OddbitCoder/PartnerGDP/fix/fix1.png

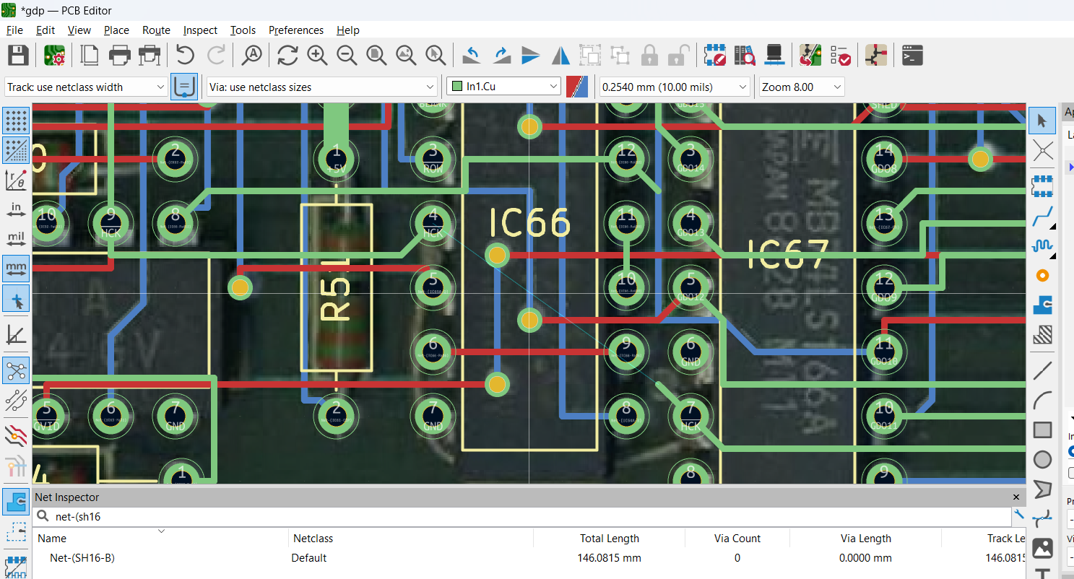
fix/fix1.png
