OddbitCoder/PartnerGDP/doc/back_flipped.jpg

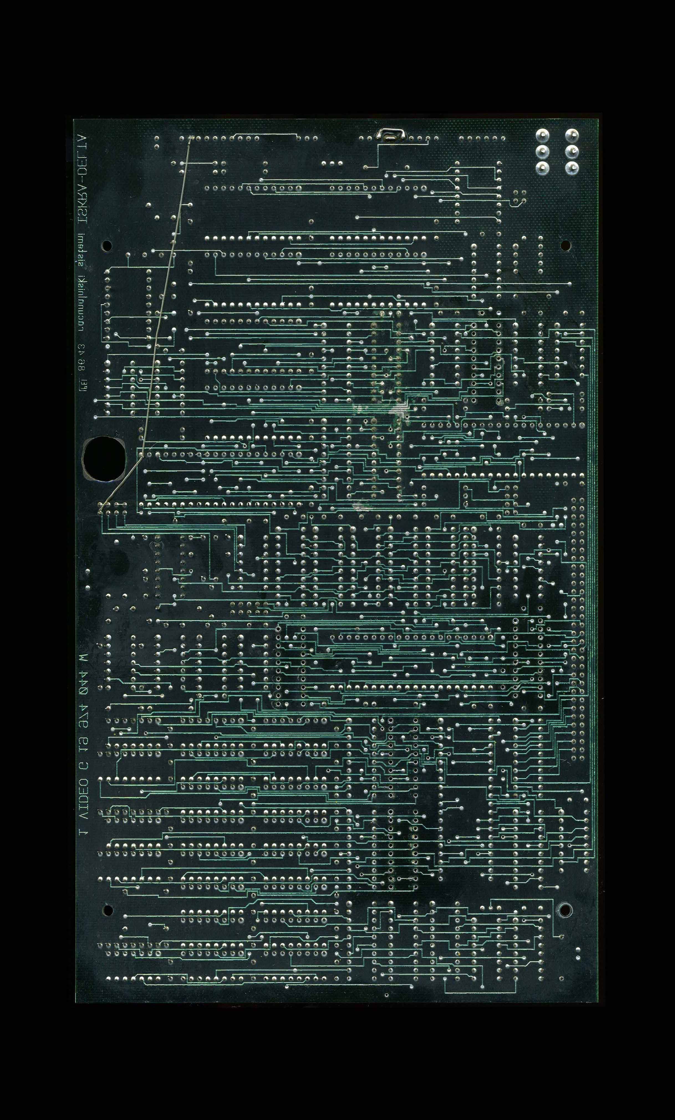
doc/back_flipped.jpg
