OddbitCoder/PartnerGDP/README.md

# GDP Component Tables

## Resistors

| ID | Schema | Original | Replica |
|----|---|---|---|
| R1 | 1K | 1K | |
| R2 | 1K | 1K | |
| R3 | 1K | 1K | |
| R4 | 1K | 1K | |
| R5 | 1K | 1K | |
| R6 | 1K | 1K | |
| R7 | 2K2 | 2K2 | |
| R8 | 10K | 10K | |
| R9 | 10K | 10K | |
| R10 | 10K | 10K | 20K |
| R11 | 10K | 10K | |
| R12 | 10K | 10K | |
| R13 | 3K3 | 3K3 | |
| R14 | 2K2 | 2K2 | |
| R15 | 330 | 300 | |
| R16 | 2K2 | 2K2 | |
| R17 | 2K2 | 2K2 | |
| R18 | 2K2 | 2K2 | |
| R19 | 2K2 | 2K2 | |
| R20 | 2K2 | 2K2 | |
| R21 | 330 | 300 | |
| R22 | 2K2 | 2K2 | |
| R23 | 2K2 | 2K2 | |
| R24 | 120 | 120 | |
| R25 | 1K | 1K2 | |
| R26 | 47 | ? | |
| R27 | 220 | 220 | |
| R28 | 1K | 1K | |
| R29 | 220 | 220 | |
| R30 | 75 | 51 | |
| R31 | 75 | 75 | |
| R32 | 2K2 | 2K2 | |
| R33 | 2K2 | 2K2 | |
| R34 | 470 | 470 | |
| R35 | 2K2 | 2K2 | |
| R36 | 2K2 | 2K2 | |
| R37 | 1K5 | 1K5 | |
| R38 | 1K8 | 1K8 | |
| R39 | 180 | 180 | |
| R40 | 50 | 75 | |
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
| R47 | 820 | N/A (composite monitor only) | |
| R48 | 1K | 1K | |
| R49 | 2K2 | 2K2 | |
| R50 | 470 | 510 | |
| R51 | 1K | 1K | |
| R52 | 2K2 | 2K2 | |
| R53 | 2K2 | 2K2 | |
| R54 | 470 | 510 | |
| R55 | N/A | 2K2 | |
| R56 | N/A | 2K2 | |

## Capacitors

| ID | Schema | Original | Replica |
|----|---|---|---|
| CK1 | N/A | 0.1µF | 0.1µF |
| CK2 | N/A | 0.1µF | 0.1µF |
| CK3 | N/A | 0.1µF | 0.1µF |
| CK4 | N/A | 0.1µF | 0.1µF |
| CK5 | N/A | 0.1µF | 0.1µF |
| CK6 | N/A | 0.1µF | 0.1µF |
| CK7 | N/A | 0.1µF | 0.1µF |
| CK8 | N/A | 0.1µF | 0.1µF |
| CK9 | N/A | 0.1µF | 0.1µF |
| CK10 | N/A | 0.1µF | 0.1µF |
| CK11 | N/A | 0.1µF | 0.1µF |
| CK12 | N/A | 0.1µF | 0.1µF |
| CK13 | N/A | 0.1µF | 0.1µF |
| CK14 | N/A | 0.1µF | 0.1µF |
| CK15 | N/A | 0.1µF | 0.1µF |
| CK16 | N/A | 0.1µF | 0.1µF |
| CK17 | N/A | 0.1µF | 0.1µF |
| CK18 | N/A | 0.1µF | 0.1µF |
| CK19 | N/A | 0.1µF | 0.1µF |
| CK20 | N/A | 0.1µF | 0.1µF |
| CK21 | N/A | 0.1µF | 0.1µF |
| CK22 | N/A | 0.1µF | 0.1µF |
| CK23 | 10µF | 10µF 16V | |
| CK24 | N/A | 0.1µF | 0.1µF |
| CK25 | N/A | 0.1µF | 0.1µF |
| CK26 | N/A | 0.1µF | 0.1µF |
| CK27 | N/A | 0.1µF | 0.1µF |
| CK28 | N/A | 0.1µF | 0.1µF |
| CK29 | N/A | 0.1µF | 0.1µF |
| CK30 | N/A | 0.1µF | 0.1µF |
| CK31 | N/A | 0.1µF | 0.1µF |
| CK32 | N/A | 0.1µF | 0.1µF |
| CK33 | N/A | 0.1µF | 0.1µF |
| CK34 | N/A | 0.1µF | 0.1µF |
| CK35 | N/A | 0.1µF | 0.1µF |
| CK36 | N/A | 0.1µF | 0.1µF |
| CK37 | N/A | 0.1µF | 0.1µF |
| CK38 | N/A | 0.1µF | 0.1µF |
| CK39 | N/A | 0.1µF | 0.1µF |
| CK40 | N/A | 0.1µF | 0.1µF |
| CK41 | N/A | 0.1µF | 0.1µF |
| CK42 | N/A | 0.1µF | 0.1µF |
| CK43 | N/A | 0.1µF | 0.1µF |
| CK44 | N/A | 0.1µF | 0.1µF |
| CK45 | N/A | 0.1µF | 0.1µF |
| CK46 | N/A | 0.1µF | 0.1µF |
| CK47 | N/A | 0.1µF | 0.1µF |
| CK48 | N/A | 0.1µF | 0.1µF |
| CK49 | N/A | 0.1µF | 0.1µF |
| CK50 | N/A | 0.1µF | 0.1µF |
| CK51 | N/A | 0.1µF | 0.1µF |
| CK52 | 22pF | 22pF | |
| CK53 | 0.22µF | 0.1µF | |
| CK54 | N/A | 0.1µF | 0.1µF |
| CK55 | 2.2nF | 68pF (?) | |
| CK56 | N/A | 0.1µF | 0.1µF |
| CK57 | N/A | 0.1µF | 0.1µF |
| CK58 | N/A | 0.1µF | 0.1µF |
| CK59 | N/A | 0.1µF | 0.1µF |
| CK60 | N/A | 0.1µF | 0.1µF |
| CK61 | N/A | 0.1µF | 0.1µF |
| CK62 | 0.22µF | 0.22µF | |
| CK63 | 10pF | N/A | |
| CK64 | N/A | N/A | |
| CK65 | N/A | 22pF | |

# Diffs

The following differences were found between the original schema and the original board:

- The original schema does not contain decoupling capacitors. Most +5V/GND connections on ICs are also missing.
- AVDINT- is connected to ST8 (single-pin header), which is missing from the original schema.
- Pull-down resistors R55 and R56 for signal lines ATTD6 and ATTD7 are missing from the original schema.
- R32 is connected to +5V in the original schema but is connected to GND on the board.
- SH3 exists in the original schema but is not present on the board.
- GDP RAM pin numbers in the original schema are mostly incorrect.
- CK64 and CK65 are not in the original schema. CK64 is not installed on the original board; CK65 is a 22pF capacitor on the original board.
- IC17/8 is not connected to AVINT on the original board.
- IC17/9 is not connected to GINT on the original board.

# Mods

## HCK Mod

On the original board, the trace between IC67/7 and IC66/12 is physically cut by a drilled hole between IC66 and IC67. A wire is added from IC67/7 to IC66/4.

This mod is implemented in commits #3f22–#c79c.

## Video Output Stabilization Mod

The document (Odprava-napak-graficne-kartice.pdf, "Tresenje slike na graficnih PARTNERJIH") contains the following steps for stabilizing the text video output:

1. Carefully cut the PCB trace running from pin 13 of IC1 to the via. Be careful: the PCB is a four-layer board.
2. Connect pin 6 of IC11 to pin 8 of IC11.
3. Connect pin 8 of IC11 to pin 10 of IC11.
4. Connect pin 6 of IC11 to pin 9 of IC71.
5. Route the GDPSYNC signal from SH11 - the contact on the IC51 side - to pin 13 of IC51.
6. Connect pin 12 of IC51 to pin 5 of IC11.
7. Route the EOC signal from pin 15 of IC61 to pin 11 of IC51.
8. Connect pin 10 of IC51 to pin 9 of IC11.
9. Route the CLKEN signal from pin 8 of IC1 to pin 11 of IC11.
10. Install a resistor of approximately 300 Ω between pins 10 and 14 (+5 V) of IC11. Anything from 220 Ω to 470 Ω is acceptable.
11. Connect pin 13 of IC1 to pin 8 of IC71.

This mod is NOT implemented on the original board.

## Keyboard Comparator Threshold Mod

Replace R10 (10K) with a 20K resistor. Keep the TTL keyboard jumpers on ST3 (ST3/5–ST3/8 and ST3/6–ST3/7) as they are.

### Why

IC3A (LM393) receives keyboard data on ST3/4 and passes it to the motherboard on ST2/2.

- **IC3/3 (+ input):** keyboard data. R8/R9 (10K/10K) hold it at 2.5V when no keyboard is connected.
- **IC3/2 (− input):** reference level. In TTL mode, the jumpers connect it to R10 (10K to +5V) and R11 (10K to GND), so it also sits at 2.5V.

With the keyboard unplugged, both inputs are at 2.5V, so the output is undefined. It depends on part tolerances and noise. If it ends up low or switching, the motherboard sees a constant break or garbage on its keyboard input. The firmware then gets stuck and the AVDC text display does not work. The keyboard has to stay connected, or ST2 has to be unplugged.

The original board happens to settle high (idle), so it works by luck. The replica settled low.

Changing R10 to 20K lowers the reference on IC3/2 to about 1.7V:

- **Keyboard unplugged:** IC3/3 (2.5V) is clearly above IC3/2 (1.7V), so the output idles high (about 4.6V on IC3/1).
- **Keyboard connected:** 1.7V is close to the standard TTL threshold, so keyboard highs and lows are detected with good margin. The old 2.5V threshold was marginal even for valid TTL highs (2.4V minimum).

This mod is implemented on the replica board. It is NOT implemented on the original board and is not shown in the KiCad schematic.
