OddbitCoder/PartnerGDP/doc/SCB2675.pdf

This Material Copyrighted By Its Respective Manufacturer
