OddbitCoder/PartnerGDP/doc/front.jpg

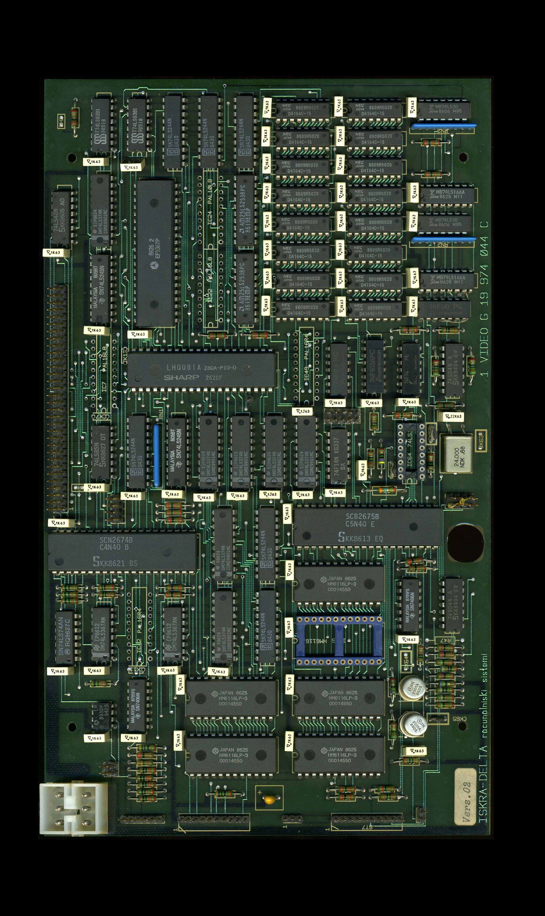
doc/front.jpg
