OddbitCoder/PartnerGDP/doc/graf1.jpg

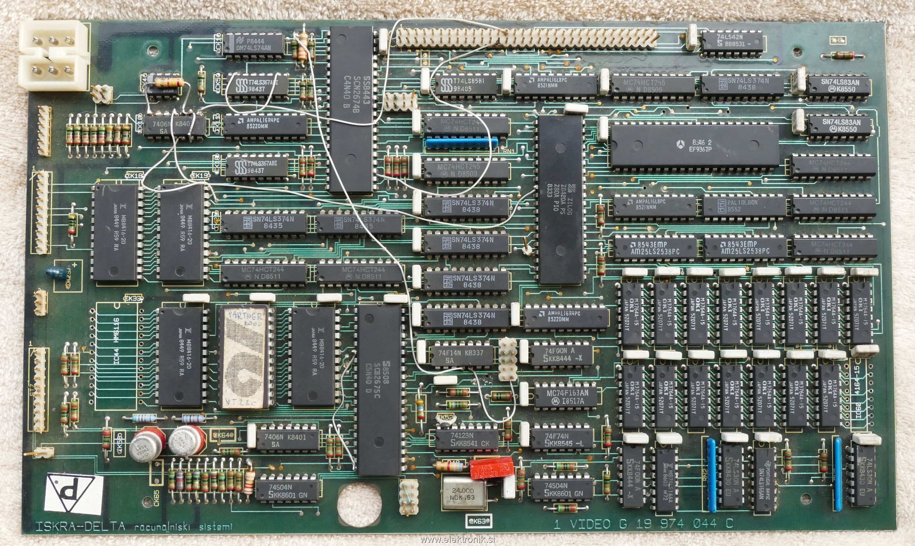
doc/graf1.jpg
