OddbitCoder/PartnerGDP/bom-c.txt

CK1,CK2,CK3,CK4,CK5,CK6,CK7,CK8,CK9,CK10,CK11,CK12,CK13,CK14,CK15,CK16,CK17,CK18,CK19,CK20,CK21,CK22,CK24,CK25,CK26,CK27,CK28,CK29,CK30,CK31,CK32,CK33,CK34,CK35,CK36,CK37,CK38,CK39,CK40,CK41,CK42,CK43,CK44,CK45,CK46,CK47,CK48,CK49,CK50,CK51,CK54,CK56,CK57,CK58,CK59,CK60,CK61 57      U10
CK23    1       10U ok (10u 16V)
CK52    1       22P ok (22p)
CK53    1       U22 ok (0.1u)
CK55    1       2N2 ok (68p)
CK62    1       U22 ok (0.22u)
CK63    1       10P ok (/)
CK64			(/)
CK65    1       (22p)
