OddbitCoder/PartnerGDP/bom-r.txt

R1,R2,R3,R4,R5,R6 - 1K 
R28,R42,R48,R51 1K OK

R25 1K2 (shema 1K)
R7 1K2 (shema 2K2)
R17 1K2 (shema 2K2)
R41 R46 1K2

R14,R16 2K2 OK
R18,R19,R20,R22,R23,R32,R33,R35,R36,R45,R49,R52,R53,R55,R56 2K2 OK

R8,R9,R10,R11,R12 10K OK

R13 3K3 OK

R15,R21   300 (shema 330)

R24 110 (shema 120)

R26 31.6 (shema 47)

R27,R29 220 OK

R30 51 (shema 75)

R31 75 OK

R34 470 OK

R50 R54 510 (shema 470)

R37 R44 1K5 OK

R38 1K9 (shema 1K8)

R39 190 (shema 180)

R40 75 (shema 50)

R43 910 (shema 680)

R47 /
