OddbitCoder/PartnerGDP/doc/GdpComponentPlacement.pptx

ST5

ST4

ST1

IC5 * SCN2674

CK3

SH2

R7

CK4

R4

CK5

CK1

IC1 * 74LS74

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
IC23 * EF9367

CK27

IC38 * D4164

IC2 * 74LS42

CK9

ST2

SH4

SH5

R13

CK10

IC11 * 7406

IC3 * LM393

CK11

IC4 * 74LS367

IC12 * PAL16R4

R5

R6

SH6

SH7

SH8

SH9

CK12

IC6 * 74LS85

IC7 * PAL16L8

IC17 * Z80 PIO

CK13

IC8 * 74LS245

IC9 * 74LS374

CK15

IC10 * 74LS83

IC14 * 74LS83

R8

R9

R10

R11

R12

R14

R15

CK16

IC15 * 74LS367

R16

R17

R18

R19

R20

CK17

IC13 * 74LS244

RN1

IC16 * 74LS245

CK14

IC18 * 74LS244

ST3

IC19 * HM6116

CK18

IC20 * HM6116

CK19

CK20

IC21 * 74LS374

R22

IC22 * PAL16L8

IC24 * PAL10L8

IC25 * 74LS244

R21

CK21

IC26 * 74LS374

IC27 * 74LS374

CK22

IC28 * 74LS374

R23

IC29 * 25LS2538
= 74LS538

IC30 * 25LS2538
= 74LS538

IC32 * 74LS244

ST6

CK23

IC44 * HM6116

CK53

CK33

IC45 * HM6116

T2

CK34

IC33 * 74LS244

IC46 * EPROM * 2732

CK35

IC47 * HM6116

IC34 * 74LS244

CK36

IC50 * SCB2675

CK37

CK24

IC35 * 74LS374

CK25

IC36 * D4164

CK26

IC37 * D4164

CK28

IC39 * D4164

CK29

IC40 * D4164

CK30

IC41 * D4164

CK31

IC42 * D4164

CK32

IC43 * D4164

ST7

CK38

CK40

R26

IC48 * 74LS374

IC51 * 74F14

SH10

SH11

SH12

CK39

CK41

IC49 * PAL16R4

IC52 * 74F00

CK42

CK43

CK44

CK45

CK46

CK47

CK48

CK49

R55

R56

R25

CK50

R27

R34

R28

SH13

SH14

R35

CK51

IC61 * 74F163

IC53 * D4164

IC54 * D4164

IC55 * D4164

IC56 * D4164

IC57 * D4164

IC58 * D4164

IC59 * D4164

IC60 * D4164

SH15

R24

R29

T1

CK65

R30

R31

CK64

R42

CK54

R47

IC63 * 7406

R32

R33

IC64 * 74LS123

CK52

CK56

R49

IC65 * 74F74

R36

CK57

CK58

CK59

CK60

CK61

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
IC71 * 74S04

SH16

SH17

SH18

O1

R48

CK55

CK62

IC72 * 74S04

R54

R50

IC66 * 74F00

R551

IC67 * 74LS166

RN2

IC68 * 74LS30

IC69 * 74LS166

R52

RN3

R53

IC70 * 74LS30

SH19

CK63
