OddbitCoder/PartnerGDP/validacija/todo.txt

[X] validacija GND layer (iz fotografije)
[X] validacija pad/via oblike, velikosti
[X] validacija +5 layerja (ali ima vsak IC napajanje?)
[X] validacija prenosa sheme (prenos omrezij v txt datoteko)
[/] Ali so nozice cipov pravilno ostevilcene? Poglej pinout sheme.
[X] ponovno preveri vse konektorje
