OddbitCoder/PartnerGDP/doc/gdp_layout_final.pdf

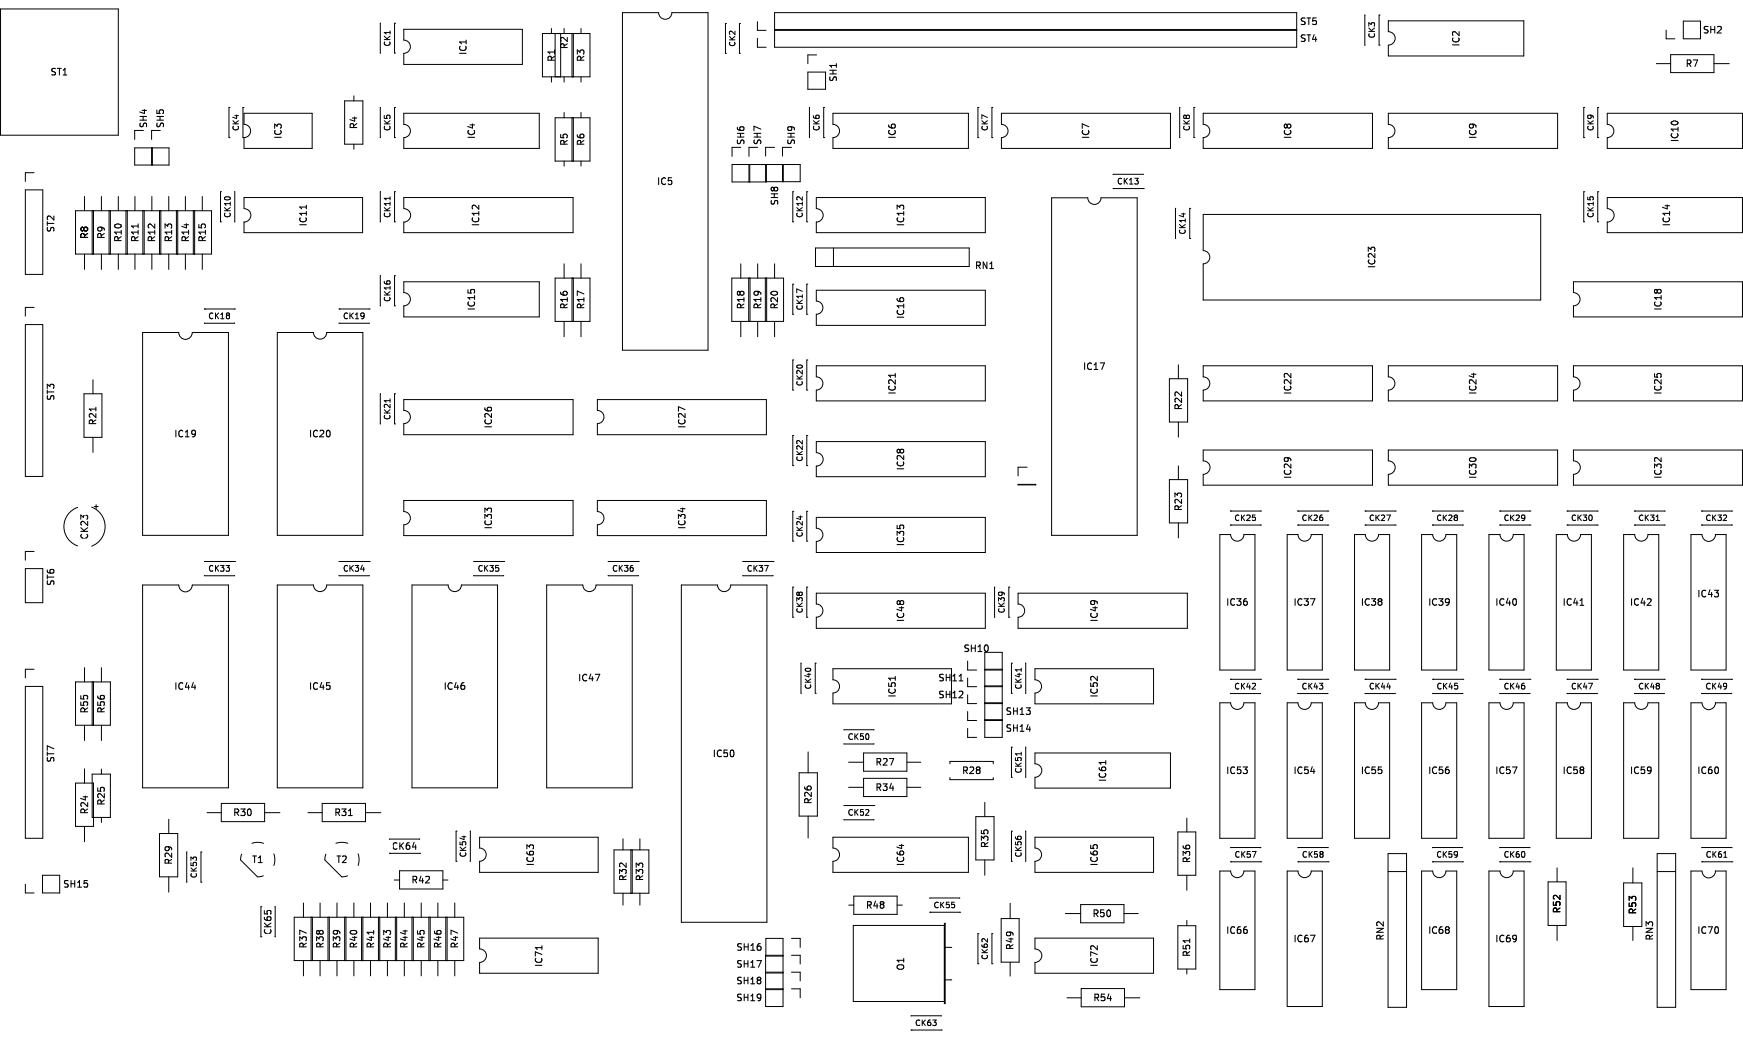
[picture p6: page 1]
