OddbitCoder/PartnerGDP/gdp/gdp.kicad_pcb

## KiCad design gdp/gdp.kicad_pcb (continued)

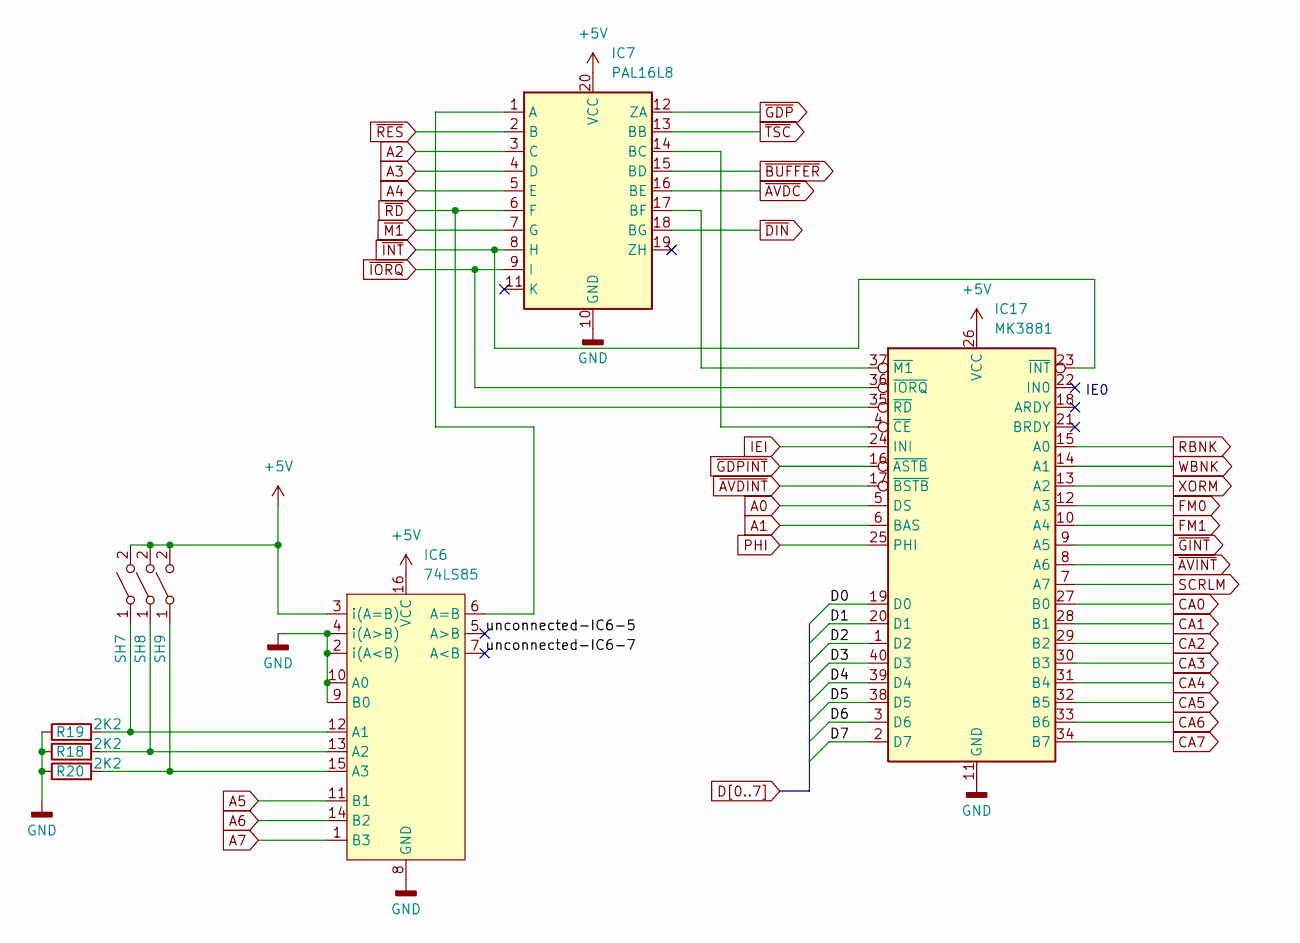
[picture p20: schematic 2.kicad_sch, PARTNER GDP: ADRESIRANJE + PIO]

Parts:
IC6: 74LS85; DIP-16_W7.62mm
IC7: PAL16L8; DIP-20_W7.62mm
IC17: MK3881; DIP-40_W15.24mm
R18, R19, R20: 2K2; R_XL
SH7, SH8, SH9: SCHALT; PinHeader_1x02_P2.54mm_Vertical

Connections:
+5V: IC6.3 (i(A=B)), IC6.16 (VCC), IC7.20 (VCC), IC17.26 (VCC), SH7.2 (B), SH8.2 (B), SH9.2 (B); also elsewhere on the board
/2/unconnected-IC6-5: IC6.5 (A>B)
/2/unconnected-IC6-7: IC6.7 (A<B)
A0: IC17.5 (DS); also elsewhere on the board
A1: IC17.6 (BAS); also elsewhere on the board
A2: IC7.3 (C); also elsewhere on the board
A3: IC7.4 (D); also elsewhere on the board
A4: IC7.5 (E); also elsewhere on the board
A5: IC6.11 (B1); also elsewhere on the board
A6: IC6.14 (B2); also elsewhere on the board
A7: IC6.1 (B3); also elsewhere on the board
CA0: IC17.27 (B0); also elsewhere on the board
CA1: IC17.28 (B1); also elsewhere on the board
CA2: IC17.29 (B2); also elsewhere on the board
CA3: IC17.30 (B3); also elsewhere on the board
CA4: IC17.31 (B4); also elsewhere on the board
CA5: IC17.32 (B5); also elsewhere on the board
CA6: IC17.33 (B6); also elsewhere on the board
CA7: IC17.34 (B7); also elsewhere on the board
D0: IC17.19 (D0); also elsewhere on the board
D1: IC17.20 (D1); also elsewhere on the board
D2: IC17.1 (D2); also elsewhere on the board
D3: IC17.40 (D3); also elsewhere on the board
D4: IC17.39 (D4); also elsewhere on the board
D5: IC17.38 (D5); also elsewhere on the board
D6: IC17.3 (D6); also elsewhere on the board
D7: IC17.2 (D7); also elsewhere on the board
FM0: IC17.12 (A3); also elsewhere on the board
FM1: IC17.10 (A4); also elsewhere on the board
GND: IC6.2 (i(A<B)), IC6.4 (i(A>B)), IC6.8 (GND), IC6.9 (B0), IC6.10 (A0), IC7.10 (GND), IC17.11 (GND), R18.1, R19.1, R20.1; also elsewhere on the board
IEI: IC17.24 (INI); also elsewhere on the board
unnamed: IC6.12 (A1), R19.2, SH7.1 (A)
unnamed: IC6.13 (A2), R18.2, SH8.1 (A)
unnamed: IC6.15 (A3), R20.2, SH9.1 (A)
unnamed: IC6.6 (A=B), IC7.1 (A)
unnamed: IC7.14 (BC), IC17.4 (~CE)
unnamed: IC7.17 (BF), IC17.37 (~M1)
PHI: IC17.25 (PHI); also elsewhere on the board
RBNK: IC17.15 (A0); also elsewhere on the board
SCRLM: IC17.7 (A7); also elsewhere on the board
WBNK: IC17.14 (A1); also elsewhere on the board
XORM: IC17.13 (A2); also elsewhere on the board
~AVDC: IC7.16 (BE); also elsewhere on the board
~AVDINT: IC17.17 (~BSTB); also elsewhere on the board
~AVINT: IC17.8 (A6); also elsewhere on the board
~BUFFER: IC7.15 (BD); also elsewhere on the board
~DIN: IC7.18 (BG); also elsewhere on the board
~GDPINT: IC17.16 (~ASTB); also elsewhere on the board
~GDP: IC7.12 (ZA); also elsewhere on the board
~GINT: IC17.9 (A5); also elsewhere on the board
~INT: IC7.8 (H), IC17.23 (~INT); also elsewhere on the board
~IORQ: IC7.9 (I), IC17.36 (~IORQ); also elsewhere on the board
~M1: IC7.7 (G); also elsewhere on the board
~RD: IC7.6 (F), IC17.35 (~RD); also elsewhere on the board
~RES: IC7.2 (B); also elsewhere on the board
~TSC: IC7.13 (BB); also elsewhere on the board

Notes on the sheet:
IE0

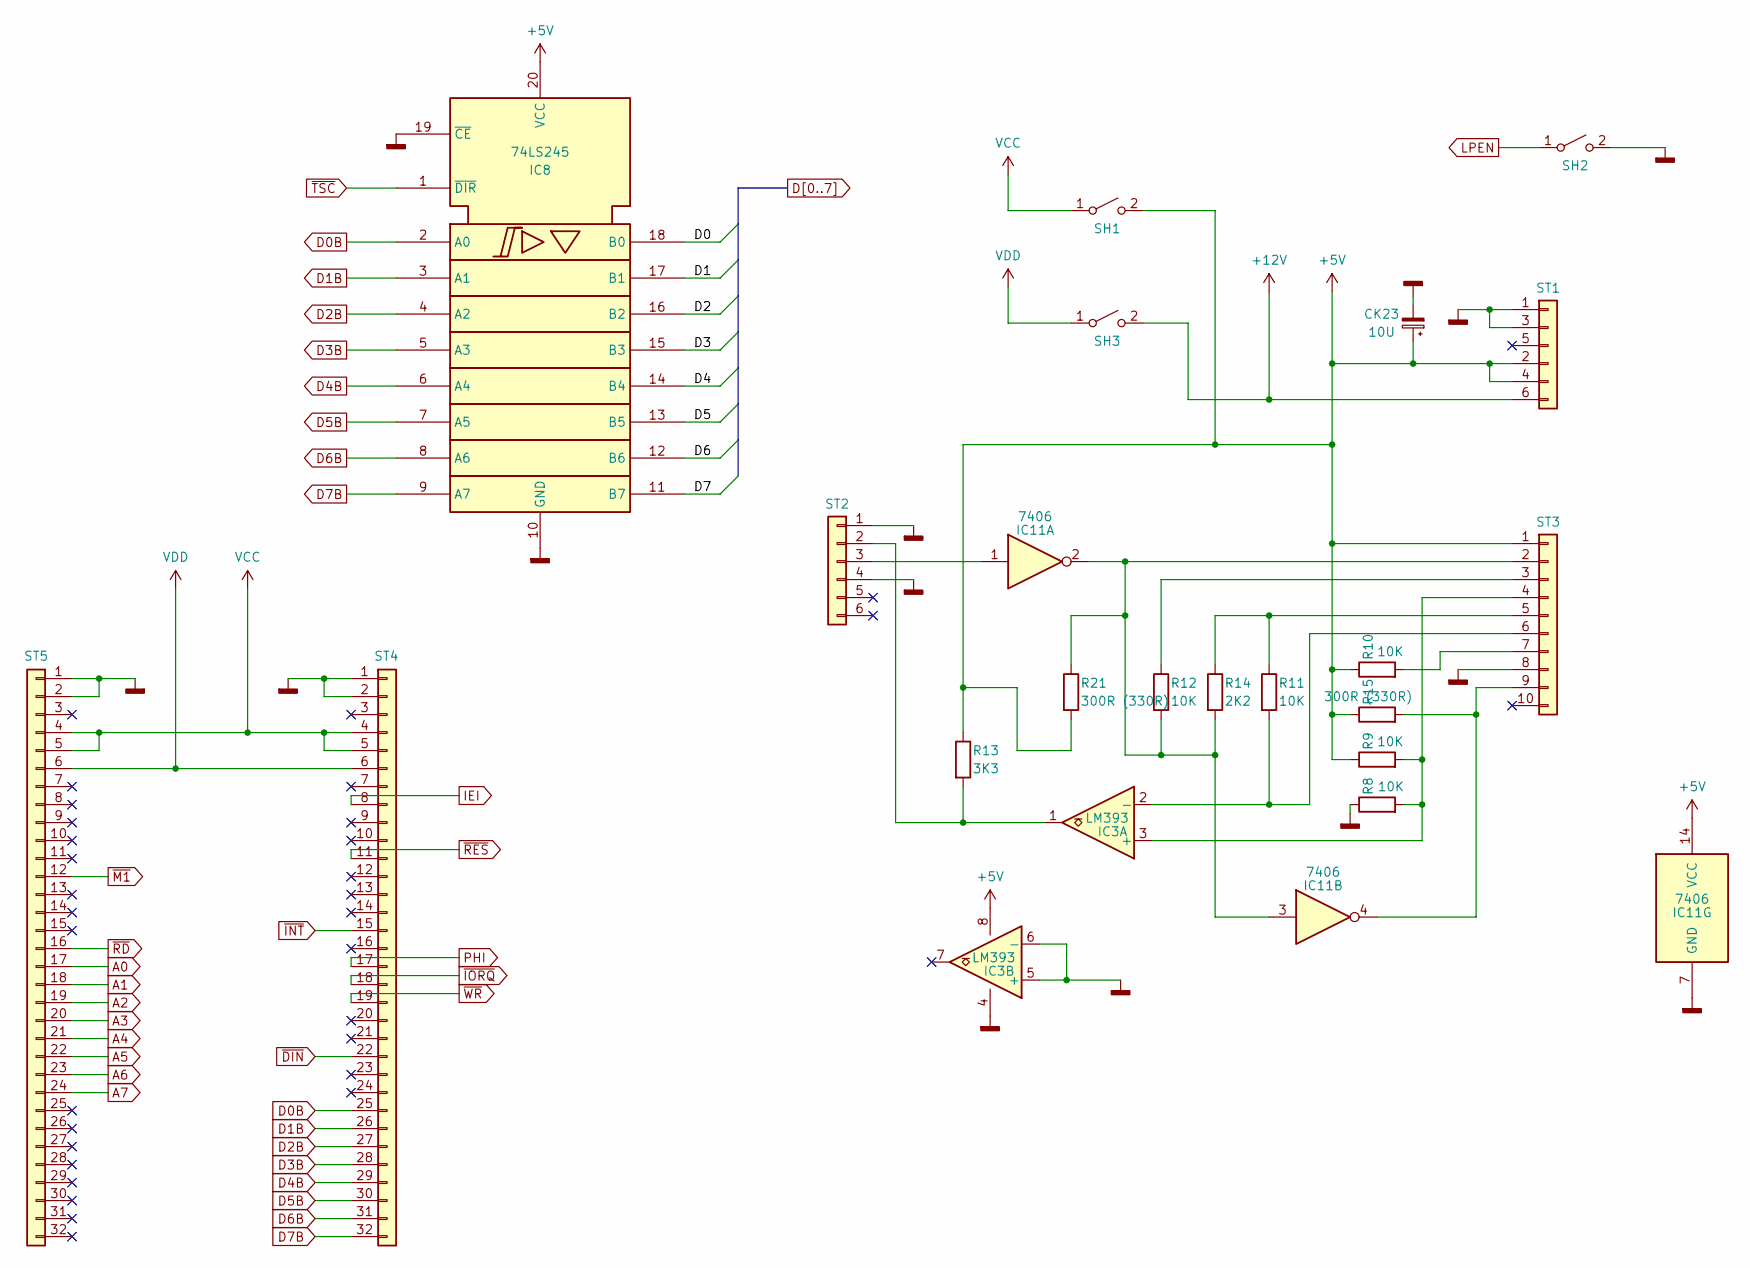
[picture p21: schematic 1.kicad_sch, PARTNER GDP: BUS + KEYBOARD INTERFACE]

Parts:
CK23: 10U; CP_Radial_Tantal_D6.0mm_P5.00mm
IC3: LM393; DIP-8_W7.62mm
IC8: 74LS245; DIP-20_W7.62mm
IC11: 7406; DIP-14_W7.62mm
R8, R9, R10, R11, R12: 10K; R_XL
R13: 3K3; R_XL
R14: 2K2; R_XL
R15, R21: 300R (330R); R_XL
SH1, SH2, SH3: SCHALT; PinHeader_1x02_P2.54mm_Vertical
ST1: 6; PWR
ST2: 6; PinHeader_1x06_P2.54mm_Vertical
ST3: 10; PinHeader_1x10_P2.54mm_Vertical
ST4, ST5: 32; PinHeader_1x32_P2.54mm_Vertical

Connections:
+5V: CK23.1, IC3.8 (V+), IC8.20 (VCC), IC11.14 (VCC), R9.1, R10.1, R13.1, R15.1, R21.2, SH1.2 (B), ST1.2, ST1.4, ST3.1; also elsewhere on the board
+12V: SH3.2 (B), ST1.6; also elsewhere on the board
A0: ST5.17; also elsewhere on the board
A1: ST5.18; also elsewhere on the board
A2: ST5.19; also elsewhere on the board
A3: ST5.20; also elsewhere on the board
A4: ST5.21; also elsewhere on the board
A5: ST5.22; also elsewhere on the board
A6: ST5.23; also elsewhere on the board
A7: ST5.24; also elsewhere on the board
D0: IC8.18 (B0); also elsewhere on the board
D0B: IC8.2 (A0), ST4.25
D1: IC8.17 (B1); also elsewhere on the board
D1B: IC8.3 (A1), ST4.26
D2: IC8.16 (B2); also elsewhere on the board
D2B: IC8.4 (A2), ST4.27
D3: IC8.15 (B3); also elsewhere on the board
D3B: IC8.5 (A3), ST4.28
D4: IC8.14 (B4); also elsewhere on the board
D4B: IC8.6 (A4), ST4.29
D5: IC8.13 (B5); also elsewhere on the board
D5B: IC8.7 (A5), ST4.30
D6: IC8.12 (B6); also elsewhere on the board
D6B: IC8.8 (A6), ST4.31
D7: IC8.11 (B7); also elsewhere on the board
D7B: IC8.9 (A7), ST4.32
GND: CK23.2, IC3.4 (V-), IC3.5 (+), IC3.6 (-), IC8.10 (GND), IC8.19 (~CE), IC11.7 (GND), R8.1, SH2.2 (B), ST1.1, ST1.3, ST2.1, ST2.4, ST3.8, ST4.1, ST4.2, ST5.1, ST5.2; also elsewhere on the board
IEI: ST4.8; also elsewhere on the board
LPEN: SH2.1 (A); also elsewhere on the board
unnamed: IC3.3 (+), R8.2, R9.2, ST3.4
unnamed: IC3.2 (-), R11.2, ST3.6
unnamed: IC3.1, R13.2, ST2.2
unnamed: IC11.1, ST2.3
unnamed: IC11.2, IC11.3, R12.2, R14.2, R21.1, ST3.2
unnamed: R12.1, ST3.3
unnamed: R11.1, R14.1, ST3.5
unnamed: R10.2, ST3.7
unnamed: IC11.4, R15.2, ST3.9
PHI: ST4.17; also elsewhere on the board
VCC: SH1.1 (A), ST4.4, ST4.5, ST5.4, ST5.5
VDD: SH3.1 (A), ST4.6, ST5.6
~DIN: ST4.22; also elsewhere on the board
~INT: ST4.15; also elsewhere on the board
~IORQ: ST4.18; also elsewhere on the board
~M1: ST5.12; also elsewhere on the board
~RD: ST5.16; also elsewhere on the board
~RES: ST4.11; also elsewhere on the board
~TSC: IC8.1 (~DIR); also elsewhere on the board
~WR: ST4.19; also elsewhere on the board

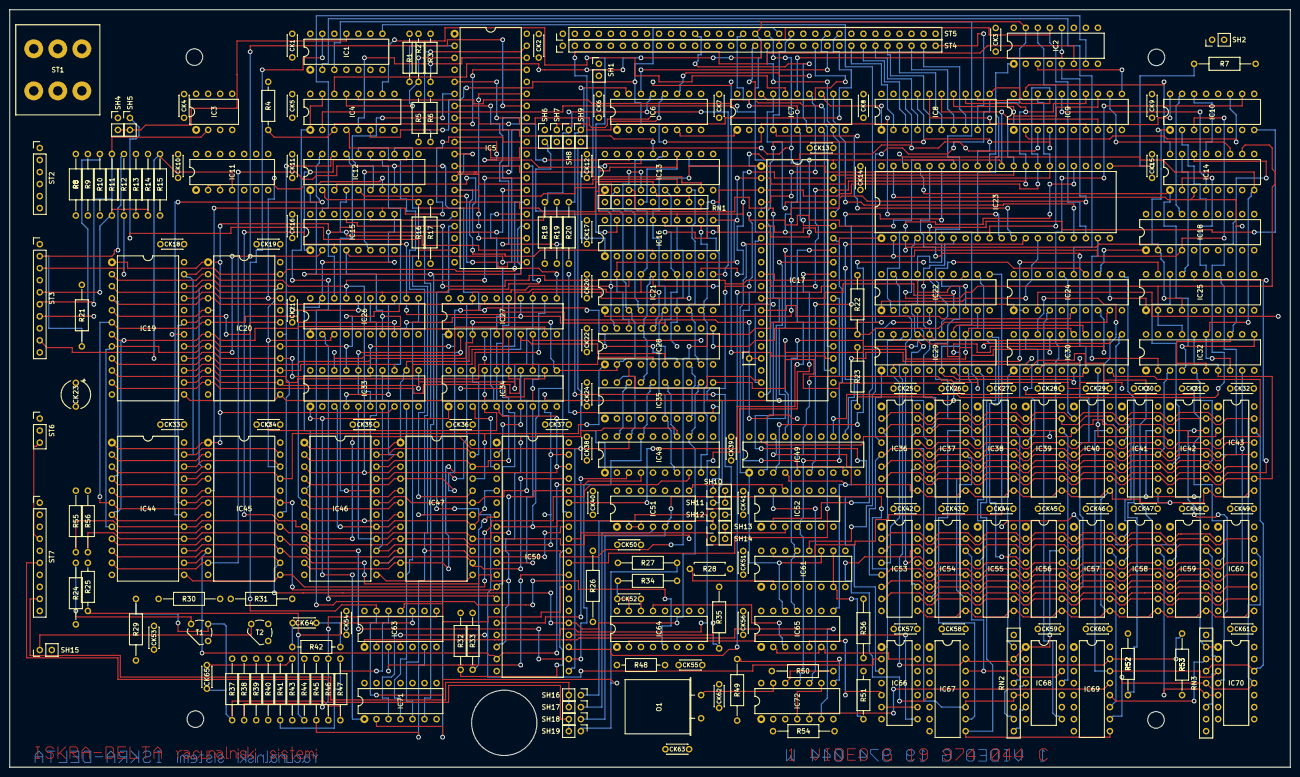
[picture p22: board gdp.kicad_pcb from above]

Board: 4 copper layers, 270.5 x 160.0 mm, 223 parts (0 on the bottom side), 330 nets.
