OddbitCoder/PartnerGDP/(commit log)

2023-09-29 EOD commit
    [gdp.kicad_pcb, gdp.kicad_sch]
2023-09-29 Adds more pages, adds schema revisions
    [1.kicad_sch, 2.kicad_sch, gdp.kicad_sch]
2023-10-02 Adds pages 4, 7, 10 (still WIP)
    [1.kicad_sch, 10.kicad_sch, 3.kicad_sch, 4.kicad_sch, 5.kicad_sch, 6.kicad_sch, 7.kicad_sch, 8.kicad_sch]
2023-10-02 Fixes sheet sizes
    [gdp.kicad_sch]
2023-10-05 Adds pg 13 (WIP)
    [10.kicad_sch, 11.kicad_sch, 12.kicad_sch, 13.kicad_sch, 14.kicad_sch, gdp.kicad_sch]
2023-10-05 Adds all page titles
    [gdp.kicad_sch]
2023-10-05 Rmv guidelines (rects)
    [gdp.kicad_sch]
2023-10-08 Some minor edits
    [1.kicad_sch, 10.kicad_sch, 13.kicad_sch, 4.kicad_sch, 7.kicad_sch]
2023-10-08 Adds page 2 (created by Tomaz)
    [2.kicad_sch]
2025-01-11 Adds Sheet 3
    [1.kicad_sch, 10.kicad_sch, 11.kicad_sch, 12.kicad_sch, 13.kicad_sch, 14.kicad_sch, 2.kicad_sch, 3.kicad_sch]
2025-01-11 Adds Sheet 5
    [1.kicad_sch, 2.kicad_sch, 3.kicad_sch, 4.kicad_sch, 5.kicad_sch, 6.kicad_sch, 7.kicad_sch]
2025-01-11 Adds Sheet 6
    [6.kicad_sch]
2025-01-11 Fixes Sheet 7
    [6.kicad_sch, 7.kicad_sch, 8.kicad_sch]
2025-01-11 Adds Sheet 8
    [6.kicad_sch, 8.kicad_sch]
2025-01-11 Fixes Sheet 5
    [5.kicad_sch, 6.kicad_sch, 8.kicad_sch, 9.kicad_sch]
2025-01-11 Adds Sheet 9
    [1.kicad_sch, 10.kicad_sch, 13.kicad_sch, 2.kicad_sch, 4.kicad_sch, 5.kicad_sch, 6.kicad_sch, 7.kicad_sch]
2025-01-12 Adds Sheet 11
    [11.kicad_sch, 13.kicad_sch, 5.kicad_sch, 6.kicad_sch, 7.kicad_sch, 8.kicad_sch]
2025-01-12 Adds Sheet 12
    [1.kicad_sch, 12.kicad_sch, 14.kicad_sch, 2.kicad_sch, 3.kicad_sch, 5.kicad_sch, 6.kicad_sch, 7.kicad_sch]
2025-01-12 Fixes IC references
    [11.kicad_sch, 12.kicad_sch, 5.kicad_sch, 6.kicad_sch, 7.kicad_sch, 8.kicad_sch]
2025-01-14 Adds component placement and board pictures
2025-01-15 Small fixes
    [1.kicad_sch, 3.kicad_sch, 8.kicad_sch]
2025-01-15 Fixes (component refs...)
    [12.kicad_sch, 13.kicad_sch]
2025-01-16 Adds Sheet 14 (WIP)
    [12.kicad_sch, 13.kicad_sch, 14.kicad_sch, 2.kicad_sch, 7.kicad_sch]
2025-01-17 Adds Sheet 14
    [14.kicad_sch]
2025-01-17 Fixes IC15
    [11.kicad_sch, 14.kicad_sch, 7.kicad_sch]
2025-01-17 Fixes Sheet 4
    [4.kicad_sch, 7.kicad_sch]
2025-01-18 Initial footprint assignment
    [1.kicad_sch, 10.kicad_sch, 11.kicad_sch, 12.kicad_sch, 13.kicad_sch, 14.kicad_sch, 2.kicad_sch, 3.kicad_sch]
2025-01-18 Minor fix
    [7.kicad_sch]
2025-01-18 Results of some measurements
    [12.kicad_sch, 13.kicad_sch, 14.kicad_sch]
2025-01-18 Several fixes
    [10.kicad_sch, 11.kicad_sch, 3.kicad_sch, 7.kicad_sch, 9.kicad_sch]
2025-01-18 Adds VCC/GND
    [10.kicad_sch, 11.kicad_sch, 12.kicad_sch, 13.kicad_sch, 14.kicad_sch, 7.kicad_sch, 8.kicad_sch, 9.kicad_sch]
2025-01-21 Fixes references
    [1.kicad_sch, 10.kicad_sch, 11.kicad_sch, 12.kicad_sch, 13.kicad_sch, 14.kicad_sch, 2.kicad_sch, 3.kicad_sch]
2025-01-21 Fixes refs
    [1.kicad_sch, 10.kicad_sch, 11.kicad_sch, 12.kicad_sch, 13.kicad_sch, 14.kicad_sch, 2.kicad_sch, 3.kicad_sch]
2025-01-22 Placing footprints...
    [1.kicad_sch, 10.kicad_sch, 12.kicad_sch, 13.kicad_sch, 14.kicad_sch, 2.kicad_sch, 3.kicad_sch, 5.kicad_sch]
2025-01-22 Fixes silkscreen
2025-01-25 Fixes footprints (PCB only)
2025-01-28 Maps footprints PCB -> sch
    [1.kicad_sch, 10.kicad_sch, 11.kicad_sch, 12.kicad_sch, 13.kicad_sch, 14.kicad_sch, 2.kicad_sch, 3.kicad_sch]
2025-01-28 Fixes footprint references in sch
    [1.kicad_sch, 10.kicad_sch, 11.kicad_sch, 12.kicad_sch, 13.kicad_sch, 14.kicad_sch, 2.kicad_sch, 3.kicad_sch]
2025-01-28 Fixes Sheet 2 symbols
    [2.kicad_sch]
2025-01-28 Final fixes
    [1.kicad_sch, 10.kicad_sch, 11.kicad_sch, 12.kicad_sch, 13.kicad_sch, 14.kicad_sch, 2.kicad_sch, 3.kicad_sch]
2025-01-28 Schema fixes
    [13.kicad_sch, 14.kicad_sch, 7.kicad_sch]
2025-01-28 Re-annotates symbols
    [12.kicad_sch, 13.kicad_sch, 14.kicad_sch, 7.kicad_sch]
2025-01-28 Adds traces
2025-01-29 Adds more copper
    [3.kicad_sch]
2025-01-29 Fixes footprints R34 R27
    [12.kicad_sch, 14.kicad_sch]
2025-01-29 Bug fix
    [11.kicad_sch]
2025-01-29 Fixes RN pin numbers
    [5.kicad_sch]
2025-01-30 Fixes resistor footprints
    [12.kicad_sch, 3.kicad_sch]
2025-01-31 Fixes labels
    [10.kicad_sch]
2025-01-31 Fixes GND
    [7.kicad_sch]
2025-01-31 Adds GND copper layer
2025-01-31 Fixes SH ref
    [12.kicad_sch]
2025-01-31 Adds script for removing nets
    [diff.txt]
2025-02-03 Fixes GND layer
    [14.kicad_sch]
2025-02-03 Adds decoupling capacitors
    [10.kicad_sch, 12.kicad_sch, 13.kicad_sch, 14.kicad_sch, 15.kicad_sch, gdp.kicad_sch]
2025-02-04 Fixes GND layer rect
2025-02-04 Adds missing GND
    [13.kicad_sch]
2025-02-04 Fixes R24/R25
    [13.kicad_sch, 14.kicad_sch]
2025-02-04 Adds GND validation images
2025-02-04 Fixes GND issue (R32)
    [1.kicad_sch, 10.kicad_sch, 4.kicad_sch]
2025-02-05 Adds R55 & R56
    [15.kicad_sch]
2025-02-05 Excludes SH3 from the board
    [1.kicad_sch, 15.kicad_sch]
2025-02-05 Updates GND validation report
2025-02-05 Adds pin 1x1
    [15.kicad_sch]
2025-02-06 Connects 1x1 pin to IC17
    [15.kicad_sch]
2025-04-11 Adds PCB layers and track widths
    [15.kicad_sch]
2025-04-14 Fixes "CA0" issue in schematics
    [1.kicad_sch, 10.kicad_sch, 11.kicad_sch, 12.kicad_sch, 13.kicad_sch, 14.kicad_sch, 15.kicad_sch, 2.kicad_sch]
2025-04-14 Green layer fixed up to first "5V barrier", left-to-right
2025-04-14 Green layer fixed up to second "5V barrier", left-to-right
2025-04-14 Polish green PCB, upper right remaining
2025-04-17 Got myself into a mess.... :(
    [15.kicad_sch]
2025-04-17 Fixes unconnected pads
    [15.kicad_sch, 5.kicad_sch]
2025-04-17 Works around KiCad bug (net naming)
    [2.kicad_sch]
2025-04-17 Adds CK65
    [13.kicad_sch, 15.kicad_sch]
2025-04-17 Adds CK64
    [13.kicad_sch]
2025-04-17 Some polishing
    [13.kicad_sch, 15.kicad_sch, 2.kicad_sch]
2025-08-17 Fixes several mistakes (1 mistake in the schema!)
    [5.kicad_sch]
2025-08-17 Fixes most of the issues (GND and PWR still pending)
2025-08-17 Further validation sync
    [2.kicad_sch]
2025-08-18 Adds IC VCC/GND connections
2025-08-19 Connectors double-checked
2025-08-20 Exports gerbers and drill files (B_PASTE, B_SILK, F_PASTE are empty)
    [gdp-B_Cu.gbr, gdp-B_Mask.gbr, gdp-B_Paste.gbr, gdp-B_Silkscreen.gbr, gdp-Edge_Cuts.gbr, gdp-F_Cu.gbr, gdp-F_Mask.gbr, gdp-F_Paste.gbr]
2025-08-21 Rmv GINT-PIO connection (not there on the board)
2025-08-21 Updates gerber files
    [gdp-B_Cu.gbr, gdp-B_Mask.gbr, gdp-B_Paste.gbr, gdp-B_Silkscreen.gbr, gdp-Edge_Cuts.gbr, gdp-F_Cu.gbr, gdp-F_Mask.gbr, gdp-F_Paste.gbr]
2025-08-25 Adds BOM
2025-10-26 Adds BOM files (WIP) and final layout
2025-10-27 Adds resistor values from reference board (schema values in brackets)
2026-05-28 Updates PCB (from schema)
