OddbitCoder/PartnerGDP/doc/graf2.jpg

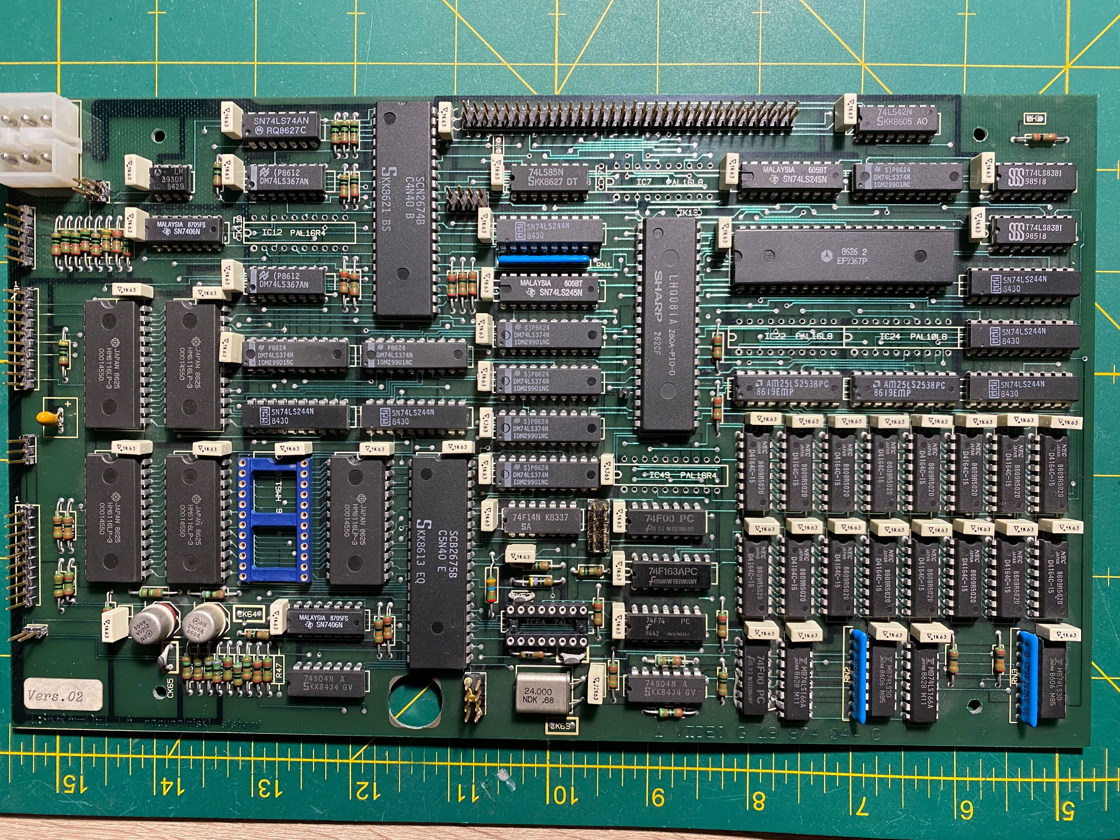
doc/graf2.jpg
